JoeyBobbles/lifepo4-battery-monitor/docs/BOM.md

# Bill of Materials (BoM)

Parts used for the LiFePO4 battery monitor, based on the supplied build list.
All costs below are in GBP (£). Pricing checked on **24 October 2026**.

## Base parts

| Part | Quantity | Unit cost | Line total | Supplier / source |
| --- | ---: | ---: | ---: | --- |
| PCB protoboard | 2 | £3.60 | £7.20 | [The Pi Hut](https://thepihut.com/products/pcb-breadboard-protoboard?variant=56083548471681) |
| Adafruit SPI non-volatile FRAM module, 64 Kbit / 8 KByte | 1 | £5.80 | £5.80 | [The Pi Hut](https://thepihut.com/products/adafruit-spi-non-volatile-fram-breakout-64kbit-8kbyte?variant=27739672465) |
| SparkFun current sensor — INA228 (Qwiic) | 1 | £14.40 | £14.40 | [The Pi Hut](https://thepihut.com/products/sparkfun-current-sensor-ina228-qwiic?variant=56219426652545) |
| DC-DC buck converter, 7–24 V to 5 V / 4 A | 1 | £4.80 | £4.80 | [The Pi Hut](https://thepihut.com/products/dc-dc-buck-converter-7-24v-to-5v-4a?variant=39865627607235) |
| 1.3-inch OLED display module, 128 × 64 | 1 | £6.00 | £6.00 | [The Pi Hut](https://thepihut.com/products/1-3-oled-display-module-128x64?variant=42810024755395) |
| ELEGOO Arduino-compatible Nano V3.0 (donated) | 1 board | £0.00 | £0.00 | [ELEGOO EU (three-board pack)](https://eu.elegoo.com/en-es/products/elegoo-nano-v3-0); donated at no cost to the builder |

## Extra parts

| Part | Quantity | Unit cost | Line total | Supplier / source |
| --- | ---: | ---: | ---: | --- |
| 120-piece 2.54 mm breakaway PCB pin header connector strip assortment kit | 1 kit | £8.99 | £8.99 | [Amazon UK](https://www.amazon.co.uk/dp/B09NDMVD2C); price paid supplied by the builder |
| 310-piece M3 male/female nylon hex standoff spacer kit | 1 kit | £7.99 | £7.99 | [Amazon UK](https://www.amazon.co.uk/dp/B09P8VB2G4); price paid supplied by the builder |

## Cost summary

| Category | Cost |
| --- | ---: |
| Base parts (including donated Nano) | £38.20 |
| Extra parts (two complete kits) | £16.98 |
| **Project total for the listed parts** | **£55.18** |

Calculation: (2 × £3.60) + £5.80 + £14.40 + £4.80 + £6.00 + £0.00
+ £8.99 + £7.99 = **£55.18**.

## Pricing basis and scope

- Pi Hut costs are the supplier's current GBP product prices, including VAT,
  retrieved from its public product data for the exact linked variants. These
  are replacement prices and may differ from the amounts originally paid.
- Amazon kit costs are the builder's reported purchase prices. Each full kit is
  counted once, including spare pieces; the number of headers and standoffs
  actually fitted has not been itemised.
- One Nano board is used and was donated, so its cost to this project is £0.00.
  The builder reported an approximate retail price of €20 for the linked
  three-board pack (about €6.67 per board). That retail value is not charged to
  this build, so no currency conversion is needed for the project total.
- The total combines current Pi Hut prices, reported Amazon purchase prices
  and the donated Nano. It is a parts-cost estimate on that basis, rather than
  a verified total of historical spending or the cost to buy every item new.
- Delivery charges are excluded. Batteries, the page button, wiring, solder,
  tools and any enclosure are outside the supplied parts list and this total.
- Prices and stock availability can change; some linked products were out of
  stock when checked.

See the [README](../README.md#bill-of-materials-bom) for the parts list without
costs and [hardware notes](HARDWARE.md) for the prototype's hardware assumptions.
