JoeyBobbles/lifepo4-battery-monitor/hardware/enclosure/battery-monitor-enclosure-enclosure.3mf

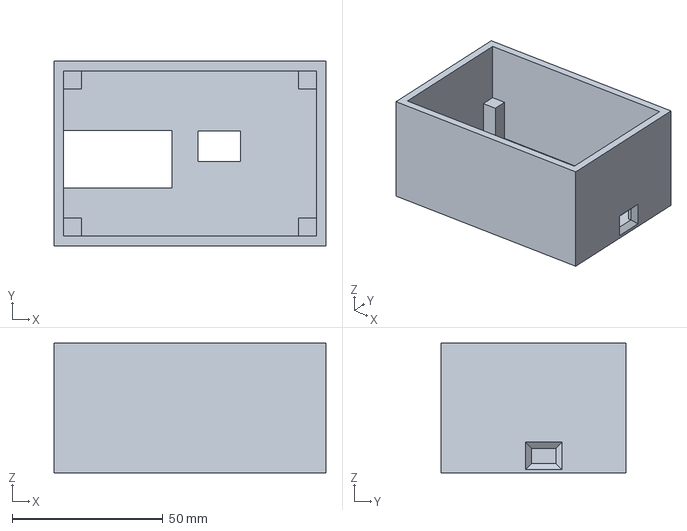
[picture p1: CAD file, 2026-11-01]
hardware/enclosure/battery-monitor-enclosure-enclosure.3mf
90.2 x 61.2 x 43.1 mm
