JoeyBobbles/lifepo4-battery-monitor/hardware/enclosure/battery-monitor-enclosure.FCStd

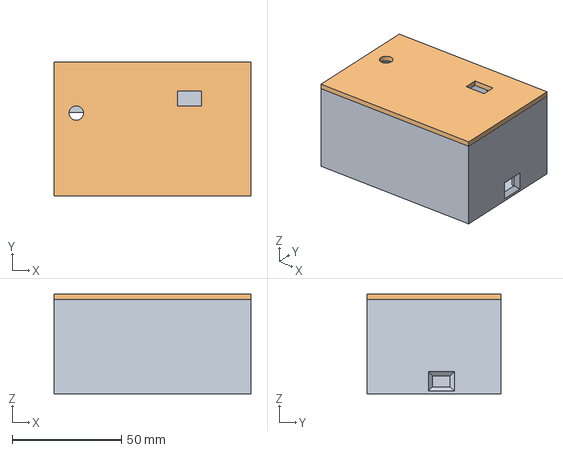
[picture p2: CAD file, 2026-11-01]
hardware/enclosure/battery-monitor-enclosure.FCStd
90.2 x 61.2 x 45.6 mm
enclosure
enclosure_lid
