JoeyBobbles/lifepo4-battery-monitor/hardware/enclosure/battery-monitor-enclosure-enclosure_lid.3mf

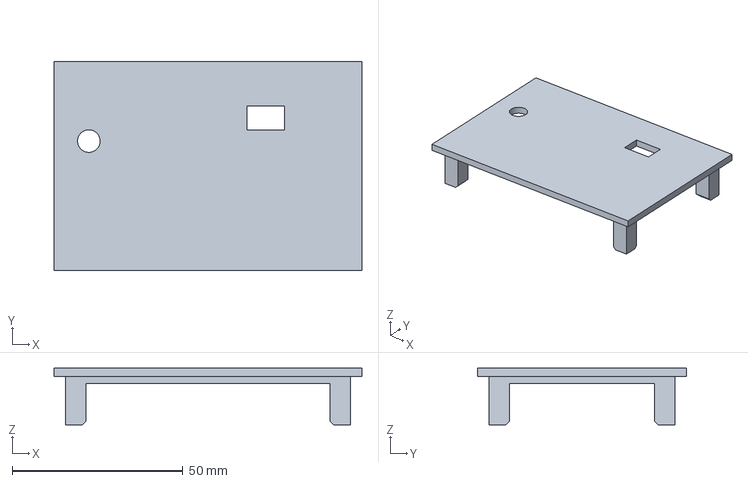
[picture p3: CAD file, 2026-10-27]
hardware/enclosure/battery-monitor-enclosure-enclosure_lid.3mf
90.2 x 61.2 x 16.6 mm
