JoeyBobbles/lifepo4-battery-monitor/(list of files, cad)

Other CAD files:
hardware/enclosure/battery-monitor-enclosure.3mf
