JoeyBobbles/lifepo4-battery-monitor/(commit log)

2026-10-21 Initial release of LiFePO4 battery monitor
    [schematic_breadboard.kicad_pcb, schematic_breadboard.kicad_sch]
2026-10-21 Flatten project into docs, hardware and firmware directories
    [schematic_breadboard.kicad_pcb, schematic_breadboard.kicad_sch]
2026-10-21 Restore schematic SVG preview in README
2026-10-24 Persist battery counters in SPI FRAM with diagnostics and hold-to-reset (#5)
    * Add resilient SPI FRAM battery counter persistence
    * Add optional OLED FRAM diagnostics page
    * Add ten-second metric reset with OLED feedback
    [Persistence.h, firmware.ino, firmware_test.cpp]
2026-10-24 Document bill of materials and project costs (#6)
2026-10-25 initial enclosure with lid for box, prototype print
    [battery-monitor-enclosure.FCStd]
2026-10-25 update to add friction fit lid to enclosure, still prototype
    [battery-monitor-enclosure.FCStd]
2026-10-25 prototype with internal supports
    [battery-monitor-enclosure.FCStd]
2026-10-26 moved files to enclosure added part files for 3D printing
    [battery-monitor-enclosure-enclosure.3mf, battery-monitor-enclosure-enclosure_lid.3mf, battery-monitor-enclosure.3mf, battery-monitor-enclosure.FCStd]
2026-10-26 moved schematics to their own folder
    [schematic_breadboard.kicad_pcb, schematic_breadboard.kicad_sch]
2026-10-26 cleaned up remaining file
    [battery-monitor-enclosure.FCStd]
2026-10-26 Minor adjustments to the lid and fresh export
    [battery-monitor-enclosure-enclosure_lid.3mf, battery-monitor-enclosure.FCStd]
2026-10-27 Added through holes for internal hardware items
    [battery-monitor-enclosure-enclosure.3mf, battery-monitor-enclosure-enclosure_lid.3mf, battery-monitor-enclosure.FCStd]
2026-11-01 added through holes for attachement points
    [battery-monitor-enclosure-enclosure.3mf, battery-monitor-enclosure.3mf, battery-monitor-enclosure.FCStd]
